The-Reto/DIY-Laserprojector_ASTEROIDS/README.md

# DIY-Laserprojector_ASTEROIDS
A clone of the popular arcadegame ASTEROIDS, emulated on a DIY Laserprojector

Please read the Report found in \Documentation for any further detail.
