The-Reto/DIY-Laserprojector_ASTEROIDS/Documentation/Report.pdf

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

# Introduction

## Summary

We are a team of three Computational Sciences students at the University of Basel. For this project we built a laserprojector using a module of 15 Kpps galvometric mirrors, a RGB-Lasermodule and an Arduino MEGA. We used this setup to emulate the classic arcade game ASTEROIDS, since the original release of this game made use of vectorized displays any pixel-based emulation is inherently inaccurate. Using our projector we were able to emulate ASTEROIDS using and directly displaying vector graphics.
The rst part of this document serves as a project report which has to be turned in for grading. The second part will go into further detail for anyone interested in how exactly we handled the technical aspects of the project. The project code as well as this document are available on GitHub (https://github.com/The-Reto/DIY-Laserprojector_ASTEROIDS).

## Context

This project was carried out within the scope of the accompanying lecture "Computer Architecture and Operating Systems" (CAOS) held by Professor Florina M. Ciorba and Professor Christian Tschudin at the University of Basel in the autumn semester of 2019.

## Team Members

The team for this project consisted of:

- Altava
- The_Reto
- L3ivel

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

# Chapter 1

# Idea & Inspiration

## 1.1 What Is a Laserprojector?

A laserprojector is a device that uses laser beams and a set of mirrors to deect those beams in order to draw lines over the projecting surface. It is used in industry for high precision tasks such as CNC machines, boat construction or leather nesting. It is also sometimes used for home entertainment as an alternative to beamers.

1.1.1 Principle

A laserprojector uses a single laser source or a combination of red, green and blue (RGB) aligned lasers. The single laser beam is then deected using two small mirrors attached to galvometric motors. It works a lot like a traditional beamer with the main dierence being that it only uses a single source of light.

1.1.2 Advantages

Laser projectors have a few advantages that make them a considerable alternative to traditional beamers. They are extremely accurate and have a wide optical angle, meaning that they can be placed very close to the projecting surface. Furthermore they consume less energy an are overall cheaper than traditional beamers.

## 1.2 Inspiration - Why Build One Yourself?

The idea to build a laserprojector came from a Youtube video from the creator "StandUpMaths". In his video titled "Recreating Asteroids with Lasers"¹ he describes the use of a laserprojector to emulate the classic arcade game ASTEROIDS. The original release of ASTEROIDS used a vector based display for all of its elements and can thus not be emulated to 100% accuracy on pixel-based monitors. The video also describes the principle of laserprojectors.
We also found several similar projects online²,3, we used these as further inspiration and reference. Generally speaking we did not use their code directly, the only two exceptions are detailed in the Technical Documentation (see 4.4 and 5.2.3).
Our team decided that the challenge of building a laserprojector would be a good t for the lecture. The problem we aimed to solve is evident, we wanted to accurately emulate ASTEROIDS and our main question is "can we do so within our budget and using a laser and a galvometric mirror?".

1https://youtu.be/FkHjG759ABY2https://www.instructables.com/id/Arduino-Laser-Show-with-Full-XY-Control3https://www.instructables.com/id/Arduino-Laser-Show-With-Real-G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

# Chapter 2

# Project Management

In this chapter we will outline our planning for the project as well as the actual execution and details where and why we deviated from our original plan.

## 2.1 Goals

We divided our goals into three categories with varying priority. The rst category is "Must Have" and is used for the goals we regard as the absolute minimum for our project to be considered a success. The second category, "Nice to Have", are goals ond features we'd very much like to accomplish but are not necessarily crucial for a bare bones version of the project. We labelled the last category as "Perfect Outcome", these are goals and featuers that are in no way necessary and may entail a massive amount of extra work - one could say these are the utopic goals.

Level | Goals
Must Have | Drawing Lissajous-Figures
Drawing arbitrary closed gures
Drawing arbitrary gures
Nice to Have | RGB-Laser for a visually more appealing results
Implementation of the ASTEROIDS game core Dimming the lasers using PWM for larger color-depth Perfect Outcome Speaker for generating sounds
Fully functioning ASTEROIDS emulation

## 2.2 Budget

Before starting the project we decided on a budget of CHF 300. We were in agreement that we'd pay all the hardware ourselves and not take advantage of the university's oering to carry parts of the costs as this would lead to the university owning parts of our hardware resulting in us having to disassemble the project once it would have been graded. By carrying all the costs ourselves we can avoid that.
After some discussing we decided that each of us would be willing to invest CHF 100, resulting in a total budget of CHF 300.

## 2.3 Distribution of tasks

Because we were condent that we'd reach all of our "Must Have" goals we were able to split the project into three parts and thus assign each team member one part. The three parts we identied were:

- Hardware
| All things related to hardware issues. What parts to use? How to mount them? Can the whole system be

portable?
Altava took responsibility for this part.
- IO-Software
Providing software abstractions for the laserpoint on the wall as well as the buttons and other parts. For use in various applications.
The_Reto took responsibility for this part.
- ASTEROIDS-Clone
The main application of our project. A functioning ASTEROIDS clone running on our hardware and using the abstractions provided by the basic IO-Software.
L3ivel took responsibility for this part.

Of course there are some overlapping areas between these three parts but they seemed distinct enough to warrant the division. While intensive communication was obviously still necessary, this nonetheless allowed each one of us to have his own schedule and workow. It also facilitates guring out each team member's contribution to the project.

## 2.4 Schedule

We did not plan out our schedule into too much detail in advance. Instead we decided to follow our goals according to their priority and seeing how far we'd get.

2.4.1 Hardware

As soon as the project idea was pitched to the teaching assistants and they gave the go-ahead, the vital hardware parts (mirrors, laser diodes, Arduino, etc.) were ordered.
The plan was to assemble the hardware once it has arrived and then start thinking about additional parts by the time the software caught up. For example we rst ordered cheap red laser diodes and planned to upgrade as soon as we were condent that the system would work.

2.4.2 Software

Since the software development was split in two parts (see 2.3), two separate plans were required. One for the IO-Software and one for the ASTEROIDS-clone.

IO-Software

The plan for the IO-Software was to start at the lowest level close to the hardware (outputting analog signals to the mirrors) and then add levels of abstractions as time goes on (letting the user set the position of the laserpoint instead of analog levels on the DAC, etc).

ASTEROIDS

The idea was to develop a platform independent ASTEROIDS-clone that could then, once the hardware and the IO-Software was done, be displayed using our projects hardware and codebase.

2.4.3 Documentation

The plan for the documentation was to wait until at least the "Must Have" goals were reached and then start to write the documentation and project report as a team eort.

## 2.5 Timeline

The following list shows a selection of major milestones in the project. Some of the dates are approximate.

Date | Milestone
07.11.2019 | Project presentation in lecture.
08.11.2019 | First time the whole system is assembled and run.
| Circles and Lissajous-gures are drawn.
09.11.2019 | Hardware is assembled into the box.
11.11.2019 | Buttons arrive and are mounted onto the box.
14.11.2019 | First successful drawing of a non-Lissajous-gure.
| We are able to draw the house gure that is still in the code.
16.11.2019 | Wiring for the buttons is done and the fan is mounted.
23.11.2019 | The box is painted, and the 3D-printed fan covers are mounted.
29.11.2019 | RGB-laser module arrives. First test of the colored laser.
| It is not yet mounted into the box.
30.11.2019 | TextRenderer is working. First display of text.
10.12.2019 | Sound module is working. We're annoying everyone in our vicinity
| with the piezo buzzer.
19.12.2019 | The RGB-Laser module is mounted into the box.
11.01.2020 | The Asteroids clone is run for the rst time.


(a) First assembly of the core parts. Note the imperfec-


tions at the edges of the square | (b) Drawing Lissajous gures.


(c) The nished laser projector. | (d) The Christmas tree gure.

# Chapter 3

# Result & Outlook

Our main goal was to create a fully functioning ASTEROIDS clone. We did not completely reach this goal. While playable, our clone is far from being complete. All in all we are still happy with our result. Details on the hardware and the software can be found in part II of this document.
However, there is a lot more we can do with the hardware and libraries we created. With our sound library and the saved RTTTL songs, we could set up a jukebox with a menu where you can select melodies to play (see 5.2.3). Another option is to nish the SVG-converter (see 5.3.2). This would allow for the user input of any .svg le that could then be displayed by our projector.
Finally we could combine all of these features in a selection menu and turn our box into a multimedia station.

## 3.1 Challenges & Deviations From Original Idea

Drawing Lissajous gures worked quite early, so we were condent that drawing closed gures would be easily achievable. Our rst idea was to use a two dimensional Fourier transform to display arbitrary closed gures, but it turned out that our xedpoint arithmetics library lacked the neccessary precision to deliver satisfactory results. We thus decided that we'd forego the Fourier transform and instead just move the laser point from vertex to vertex in a straight line. Yet it turned out to be a major obstacle to even draw clean straight lines. It appeares that the mirrors "overshoot" the target position, so when we tell them to move from position (x0,y0) to position (x0,y1), the laserpoint would stop at (x0,y1+a) and then move back, leveling out at the desired position. We suspect that this eect is due to the angular momentum of the mirrors. Our current solution is to add points inbetween, so that the mirrors don't accelerate too much and therefore reduce overshooting.
Another challenge was the arrangement of the parts in the box. We started assembling the parts into the box pretty early and a lot of the setup changed afterwards. When we installed the cooling system, which is very space consuming, we had to cut out vents and nd a suiting place for the fan. All of this had to be done without knowing the dimensions of the RGB laser module, as it arrived very late and had no technical specications provided by the seller. The interior of the box underwent several iterations, but ended up in a pretty good state, despite all the unknown variables.
After testing we found that our idea of using PWM to allow dimming of the lasers turned out to be impossible. While applying a modulated output to a stationary laser point creates the illusion of dimming the point, this technique stops working as soon as the laser point is in motion. It turns out the dimming eect on the laser point arrises from the point being turned on and o in rapid succession. When we move the laser point around using the mirrors this results in dashed or dotted lines - while this is a cool eect, it is not what we were aiming for.
The idea of adding sound came very late, but ended up being a good decision as it didn't really intervene with the rest of the project and adds very nice to the arcade feeling of our ASTEROIDS clone.
The installation of an RGB laser was decided on in the early stages of the project. We agreed that it would enhance the quality without adding much complexity. It turned out to do just that.

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

# Chapter 4

# Hardware

## 4.1 Parts Overview


Figure 4.1: The interior of our laser projector. On the left side is the lid where the buttons and the fan are embedded. On the right side are all the other parts mounted in the box.

All the parts of our laser projector are mounted in a 24cm x 17cm x 12cm wooden box. The buttons are embedded in the lid as well as the heat exhaust. On the back side is a sealable opening where the laser beam will come out of. The whole projector is powered by a single standard Swiss type power plug.

## 4.2 Arduino

The Arduino MEGA2560 controlling our projector is mounted on the bottom of the box and barely visible under the wires. It is connected to the DAC, the laser, the piezo buzzer and the buttons as well as their lights.

4.2.1 Pin Connections

Most of the Arduino output is connected to a standard breadboard using jumper wires. The DAC and the piezo buzzer are located on the breadboard, as well as some amplier circuits.
The pins of the Arduino are connected as follows.
Part | Pin Number
Piezo Buzzer | 47
SDI (DAC) | 51
SCK (DAC) | 52
CSP (DAC) | 53
LDAC (DAC) | 5
Red Laser | 40
Green Laser | 41
Blue Laser | 42
Button Interrupts | 2, 18-21
Button Lights | 30-34
4.3 | Mirrors & Galvometric Motors

Two small mirrors mounted on galvometric motors are the heart of our projector. The mirrors are capable of 25kppm (kilo points per second), meaning they can draw 25'000 distinguishable points per second on the projection surface. The motors are controlled by an accompanying PCB (printed circuit board). It can be seen right of the mirrors, mounted on the wall. The PCB has two MOSFETs (MetalOxideSemiconductor Field-Eect Transistor) and a small heatsink attached. Those MOSFETs develop a reasonable amount of heat in just a few minutes of operation, surpassing the capabilities of the already installed heatsink. This lead us to attaching a much bigger heatsink to the existing one and the additional installment of a fan.

## 4.4 DAC

The DAC (Digital-to-Analog Converter) is needed as a translator between the Arduino and the galvometric motors. It converts the digital signals of the Arduino to analog signals needed by the galvometric motors. We use a MCP4922 DAC.

## 4.5 Laser

We use an RGB laser so we can project dierent colors instead of only one. In the early stages of our project we used a cheap red laser and were not satised with the results, so we decided to upgrade our projector. The accompanying PCB is connected to the Arduino and lets us turn the dierently colored lasers (red, green and blue) on and o separately.

## 4.6 Power Supply

The power cord is connected to two dierent power supply units. One has a 15V output and powers the galvometric motors and the fan. The other one has a 5V output and powers the laser as well as the Arduino.


Figure 4.2: The laser and its controller.

4.7 | Additional Parts
4.7.1 | Buttons


Figure 4.3: Some disassembled buttons.

For playing Asteroids you need ve buttons. We used the 60mm Red Arcade Buttons by Adafruit for a real arcade-like feeling.¹ The buttons are equipped with an LED and can be lit individually by the Arduino.

4.7.2 Cooling

As mentioned in section 4.3, the operation of the galvometric mirrors produces a signicant amount of heat. In order to cool the MOSFETs, we attached a large heat sink to the existing one. This alone is a vast improvement and allows for operation over several hours with reasonable temperature development. Still we decided to install a fan and two vents to dissipate the hot air in order to protect the parts and box from taking damage.

1This project is not sponsored or supported by Adafruit in any way.

4.7.3 Box

The box is handmade out of 2cm thick maplewood. It is painted with acryllic color in the style of the original Asteroids arcade cabinet.

4.7.4 Piezo Buzzer

A late addition to the project was a piezo buzzer for simple arcade sounds, further improving the emulation of an Asteroids arcade cabinet. It is controlled by the Arduino and can generate simple notes by turning the input signal on and o at certain frequencies.

4.7.5 Other Parts

Several parts are 3D-printed. This includes the laser protection cover, the louvres and the stand aligning laser and mirrors.

## 4.8 Cost Overview

The total cost for the project ended up as follows.

Part | Price (all prices in CHF)
laser diode red | 6.00
galvometric motors with mirrors | 125.90
RGB laser module | 48.90
power supply for laser | 28.90
Arduino MEGA | 20.00
DAC | 16.00
Arcade Buttons | 29.10
Heat Sink | 5.55
Other (Resistors, Wires, Shipping etc.) | 62.40
Total | 342.75

# Chapter 5

# Software

5.1 | Software Overview & Structure
5.2 | IO Software
5.2.1 | Graphics

We provide an abstraction for the laser and the mirrors. Instead of worrying about the mirrors and the laser directly, the user should only worry about the laserpoint on the wall. The most important function in that regard is probably the following which controls the laserpoint on the wall.

1 moveLaser ( Laser *l , Command c)
A further abstraction is provided with the Drawing and Scene structs used to hold even higher level abstraction for pictures to be drawn. In the following paragraphs the details of each level of abstraction are provided.

DAC

As outlined in the hardware section (4) of this documentation, the mirrors are not directly connected to the Arduino. Instead the mirrors are connected to a DAC, the analog output is then used to control the angle of the mirrors. To control the DAC we copied, adapted and build upon public domain code found on GitHub¹
The DAC.cpp le provides functions controlling the DAC and setting its output level. This le denes a struct DAC containing the appropriate pin connections. The le provides the function DAC *generateDAC(int _SDI, int _SCK , int _CS, int _LDAC) that can be used to initialize a DAC-struct to then be used. The function also initializes the SPI-library, which is used to transfer the data to the DAC.
The function void Set(DAC *dac, unsigned int A, unsigned int B) is used to set the DAC provided in the argument *dac to the levels provided in the two arguments A and B, using the rst output channel of the DAC for the value in A and the second one for the value on the B argument. The two arguments must be between 0 and 4095, as we are using a 12-bit DAC.
The library denes the following datastructures:
- struct MCP4922 {int _SDI, _SCK, _CS, _LDAC}
holds the pin connections for the MCP4922 DAC we're using.
- typedef struct MCP4922 DAC
provides an easier name for the struct used to hold the pin connections.

The library provides the following functions:

- DAC* generateDAC(int _SDI, int _SCK, int _CS, int _LDAC)
returns a pointer to a DAC object using the provided pin numbers.
- void Set(DAC* dac, unsigned int A, unsigned int B)
sets the output channel A of the DAC provided in dac to the value in the argument A. sets the output channel B of the DAC provided in dac to the value in the argument B.

1https://github.com/helgenodland/MCP4922-Arduino-SPI-Library

Laser

The les Laser.cpp and Laser.h are probably the most important pieces of code in the whole project, as they provide the necessary functions to fully control the laser point on the wall. They provide functions, datastructures and constants for controlling position, movement and color of the laser.
The goal is to provide a level of abstraction to allow the user to control the laser point on the wall, instead of having to worry about the angle of the mirrors or the laser module.
The library provides the following datastructures:
- typedef unsigned char COLOR
Just a typedef for unsigned char to indicate its use as a color.
An unsigned char holds 8 bits, the rst two are unused for COLOR, the remaining 6 bits are shared equally across the three color-channels RGB, with two bits each. The structure is thus: EE RR GG BB
Example: 51 = 00 11 00 11 is equivalent to the color purple ({255, 0, 255}).
Note: On the current hardware we have no possibility of dimming the laser, nor the individual color-channels. This means that, currently, the laser corresponding to one color-channel will be fully activated whenever either one or both of the corresponding bits is set - eectively reducing our color-depth from 6 bits to 3.
- typedef unsigned long COMMAND
A typedef masking an unsigned long as a COMMAND. These commands are used to encode a new position for the laser to move to as well as a color during the move - thus allowing to encode any movement of the laser into 32 bits. This has two main advantages; rst it is ecient with memory, and secondly it allows the SVG-Converter (see 5.3.2) to output a CSV le containing numbers, which then in turn can easily be used on the hardware. The 32 bits of a unsigned long are used as follows:

The rst 12 bits encode the x-position.
the next 12 bits encode the y-position.
the following 6 bits encode the color (see COLOR)
the bit at the second to last position is the COLOR_CHANGE-bit. As changing the color of the laser takes a comparably large time (approx. 200 microseconds) the lasers color is not set for every point - rather it is only changed when the COLOR_CHANGE-bit is set.
the last bit is the LASER_OFF-bit, if it is set the laser will always be turned o (color black).

The overall structure of a COMMAND is thus: (x for the x-position, y for the y-position, rgb for the color and t for the two technical bits)

xxxx xxxx xxxx yyyy yyyy yyyy rrgg bbtt

- struct Laser
with the following structure:
1 | struct Laser {
2 | int x , y;
3 | COLOR color ;
4 | # ifdef USE_SIMULATOR
5 | int frame ;
6 | IMAGE target ;
7 | # else
8 | DAC dac ;
9 | # endif // USE_SIMULATOR
10 | };

This structure is used to describe one laser point (yes, we could theoretically use more than one). It holds the current position of the point and its current color. Depending on whether the simulator (see 5.3.2) is used or the actual hardware, the struct also holds either a DAC-object for use with the real hardware, or a frame for the simulator.

The library provides the following functions:

- LASER* generateLaser()
returns a laser struct with all the necessary variables initialized. The position is set to be at 2000, 2000 and the color is set to be black (i.e. laser turned o).
- void setLaserColor(LASER *l, COLOR col)
Sets the laser to the color provided.
Note: Our current hardware does not support dimmed color, see previous note on the color data structure.
- int deleteLaser(LASER* l)
Deletes the provided laser, freeing all allocated space.
- void moveLaser(LASER* l, COMMAND cmd)
Moves the laser point from its current position to the position encoded in the COMMAND. During the move the laser will keep its previous color, unless the COLOR_CHANGE-bit is set. In this case the laser will rst change its color to the color encoded in the COMMAND.
- COLOR getColor(COMMAND cmd)
Returns the color value encoded in the COMMAND cmd as a COLOR.
- COMMAND getCommand(unsigned short xPos, unsigned short yPos, COLOR col)
Returns a valid COMMAND encoding the position (xPos, yPos) and the COLOR col. Neither the COLOR_CHANGE nor the LASER_OFF-bit is set. If desired, they have to be set manually by adding the appropriate constant.
- COMMAND addCorrection(int x, int y, COMMAND c)
Adds an oset to the position in the provided COMMAND.

Drawing

The library Drawing provides further abstractions for the graphical output of our projector. Providing a struct called drawingObject holding position, rotation, scale etc. of a drawable object. Furthermore it allows for the grouping of several drawingObcects into a scene consisting of an array of drawingObjects and, crucially, an array of COMMANDs that can directly be drawn using the laser class.
The library provides the following datastructures:
- struct drawingObject
with the following structure:
1 | struct drawingObject {
2 | char type ;
3 | Vector pos ;
4 | short rot ;
5 | short scale ;
6 | int len ;
7 | COLOR color ;
8 | const short * data ;
9 | };
- struct scene
with the following structure:
1 | struct scene {
2 | int noOfObjects ;
3 | int noOfPoints ;
4 | drawingObject objects [16];
5 | COMMAND * cmds ;
6 | };

The library provides the following functions:

- scene* makeScene()
Returns a pointer to an empty scene object.
- void deleteScene(scene* s)
Deletes a scene, freeing all allocated memory. Scenes must be destroyed this way.

- void addObjectToScene(scene* scene, drawingObject object)
Adds a drawingObject to the scene provided.
- void buildScene(scene* s)
Renders the scene by iterating through all the objects in the scene and generating the array of commands. Note: This function must be called before the scene is drawn the rst time. It must also be called when there have been updates to the position, rotation or any other relevant eld of an object.
- void drawScene(scene toDraw, LASER l)
Draws the scene using the laser provided.

The library provides the following constants and variables:

- static drawingObject HOUSE
A drawingObject providing the image of a simplied house.
- static drawingObject SHIP
A drawingObject providing the image of a spaceship - this is the graphic used in the ASTEROIDS game.
- static drawingObject ROCK
A drawingObject providing the image of an abstract boulder - this is the graphic used for the eponymous asteroids in the game.
- static drawingObject TREE
A drawingObject providing the image of a simplied (Christmas) tree. This object was added shortly before Christmas to aid with the festive spirit during development.


Figure 5.1: Visualization of the forms we can draw.

TextRenderer

The TextRenderer library is used to render text onto a scene. The library provides the following function:

- void renderString(scene* s, String str, Vector pos, COLOR col)
Adds objects to the scene* s to spell out the string provided. Vector pos provides the position of the rst letter in the string and COLOR col the color of the whole string.

The library provides the following constants and variables:

- extern const drawingObject alphabet[]
An array of drawingObjects containing the upper case letters of the latin alphabet in alphabetical order. Numbers to be added soon.

5.2.2 Buttons

The CAOSButtons library provides all the functionality of the ve buttons on top of the box. It allows the user to set each button individually to one of three behaviours (trigger when button down, button up or button change). The library is also used to control the LED in each of the buttons for light eects.
The library supports the following ve buttons corresponding to our hardware:
- L_BUTTON (Left Button)
- T_BUTTON (Thrust Button)
- R_BUTTON (Right Button)
- F_BUTTON (Fire Button)
- H_BUTTON (Hyperspace Button)

The buttons can be in one of the following modes:

- BUTTON_DOWN
The action assigned to the button in question is triggered whenever the button goes from "not pressed" to "pressed".
- BUTTON_UP
The action assigned to the button in question is triggered whenever the button goes from "pressed" to not "pressed".
- BUTTON_CHANGE
The action assigned to the button in question is triggered whenever the button changes its state.

Each of the lights can be set to one of the following states:

- ON
The light will be turned on.
- OFF
The light will be turned o.
- RANDOM
The light will be randomly assigned to be on or o.
- SAME
The light will not change its state.
Note: This functionality comes in handy when one tries to change multiple (but not necessarily all of them) lights at once using the setLightPattern function (see below).

The library provides the following functions:

- void setUpButtons()
Sets up all the buttons, attaches the appropriate interrupts and sets the concerning hardware pins to the appropriate mode.
Note: This function must be called before any of the functionalities of the library can be used.
- void setInterrupt(char button, char mode, void (*f)())
This function is used to set the desired behaviour of a button. The user can specify the button in question, the mode desired and a function pointer to the function that should be called whenever the trigger criterion is met.
char button can be set to either one of the following: L_BUTTON, T_BUTTON, R_BUTTON, F_BUTTON, H_BUTTON.
char mode can be set to either one of the following: BUTTON_DOWN, BUTTON_UP, BUTTON_CHANGE.
void (*f)() can be set to an arbitrary function, that is to be triggered when the criterion set in mode is met.

- void setLight(char button, char state)
This function is used to set the state of an individual light. char button can be set to either one of the following:
L_BUTTON, T_BUTTON, R_BUTTON, F_BUTTON, H_BUTTON.
char state can be set to either one of the following:
ON, OFF, RANDOM, SAME.
- void setLightPattern(char *pattern)
Function used to set all the states of the lights at once.
char *pattern is an array containing ve states, the lights in the buttons will be set to the corresponding state (order is the one given above: [L, T, R, F ,H]).
- void setRandomLightPattern()
Sets all ve lights to RANDOM.

5.2.3 Sound

The sound library provides all functionality for the piezo buzzer used in the project. This functionality consists of the ability to play single notes for a given amount of time or to play one of the 20 handpicked songs available. These songs are stored in the RTTTL (Ring Tone Text Transfer Language, developed by Nokia in the 1990 to facilitate sharing and creating of monotone ringtones).
The code was largely copied and then adapted from a public GitHub project²
. The songs available in the RTTTL are copied from a le containing over 42'000 such songs we found online³,4
The library provides the following constants and variables:
- Frequencies of all 88 standard piano keys
These are provided as compile time makros of the format NOTE_ plus name. The names range from B0 to DS8. Example: The note C of the 4th octave has the following denition:
#define NOTE_C4 262.

- Strings containing 20 selected songs and melodies
Note: Not all of the melodies are equally recognisable when played on a piezo buzzer.

const char SIMPSONS[]
The intro melody of the hit TV-series The Simpsons.

const char INDIANA_JONES[]
The intro to the title piece of the movie Indiana Jones.

const char TAKE_ON_ME[]
The melody of the song Take On Me.

const char LOONEY_TUNES[]
The intro melody of the hit TV-series LOONEY TUNES.

const char TWENTYEST_CENT_FOX[]
The melody of the 20th Century Fox production logo.

const char JAMES_BOND[]
The musical motif associated with the movie hero James Bond.

const char STAR_WARS[]
The intro to the opening theme of Star Wars.

const char TOP_GUN[]
The intro to the opening theme of the movie Top Gun.

const char A_TEAM[]
The intro melody of the hit TV-series The A-TEAM.

const char FLINTSTONES[]
The intro melody of the hit TV-series The Flintstones.

2https://github.com/spicajames/Rtttl3http://www.picaxe.com/RTTTL-Ringtones-for-Tune-Command4http://www.cellringtones.com

const char SMURFS[]
The intro melody of the hit TV-series The Smurfs.

const char MISSION_IMPOSSIBLE[]
The intro of the opening theme of the Mission Impossible movies.

const char WORMS[]
The melody of the hit computer game Worms.

const char PIRATES[]
The intro to the opening theme of the The Pirates of the Carrabian movies.

const char SCHWEIZER_PSALM[]
The opening bars of the Swiss National Anthem.

const char FINAL_COUNTDOWN[]
The melody of the refrain of the song The Final Countdown.

const char BOHEMIAN[]
The opening bars of the song Bohemian Rhapsody.

const char FUR_ELISE[]
The opening bars of the song Für Elise.

const char MY_HEART_WILL[]
The melody of the refrain of the song My Heart Will Go On.

const char HARRY_POTTER[]
The intro to the opening theme of the Harry Potter movies.

The library provides the following functions:

- void playTone(int freq, long duration)
Used to play a single frequency int freq for a given amount of time long duration in milliseconds.
This function is non blocking - meaning the rest of the code can be executed while the tone is playing (e.g. there can be a graphics output at the same time).
- void play_rtttl(const char p[])
Plays the melody provided in const char p[]. One can either use one of the included RTTTL strings or input anotherone, the string (p[]) must however be stored in the program memory of the Arduino.
This function is blocking - meaning that no other action can be executed while the song is played. This unfortunatelly forbids us from playing a song while also displaying an image at the same time.
5.3 | Utilities
5.3.1 | Mathematical Tools

Fixed point arithmetics

The FixPoint library provides arithmetics for xed point numbers. We chose to use xed point arithmetics instead of standard oating point for performance reasons, as we decided that they also provide the neccesary precision. The library provides the following datastructures:

- typedef long FIXPOINT
A typedef used to indicate that a given variable of type long should be interpreted as an FIXPOINT.
- typedef unsigned long U_FIXPOINT
A typedef used to indicate that a given variable of type unsigned long should be interpreted as an U_FIXPOINT.

In either case (singed or unsigned) our xed points use 16 bits of precision.
The library provides the following functions:
- FIXPOINT intToFixed(int x)
Converts an integer into its xed point representation.

- int fixedToInt(FIXPOINT x)
Converts a xed point value into an integer. Non integer values are always rounded down.
- FIXPOINT doubleToFixed(double x)
Converts a oating point number into its xed point representation.
- double fixedToDouble(FIXPOINT x)
Converts a xed point value into its oating point counterpart.
- FIXPOINT fpMultiplication(FIXPOINT x, FIXPOINT y)
Multiplies two xpoint values together. Attention, this operation may lead to a loss in precision.
- FIXPOINT fpDivision(FIXPOINT x, FIXPOINT y)
Divides the xed point value x by y. Attention, this operation may lead to a loss in precision.
- FIXPOINT fpSin(int angle)
Returns the xed point representation of the sine of the provided angle.
int angle is to be given in degrees, but does not have to be between 0 and 360. The calculation of the sine is done using a lookup table and there is currently no interpolation for values with a precision greater than 1 degree implemented.
- FIXPOINT fpCos(int angle)
Returns the xedpoint representation of the cosine of the provided angle.
int angle is to be given in degrees, but does not have to be between 0 and 360. The calculation of the cosine is done using a lookup table and there is currently no interpolation for values with a precision greater than 1 degree implemented.
- FIXPOINT fpErf(char x)
Returns the result of the following calculation: 1 + erf(6.1645∗(

x
256 −0.5))
2
This calculation may seem extraordinarily specic, and it certainly is. The values returned are always in [0, 1]. This function is used to interpolate lines using the laser as to not overshoot the target position. Again, the calculation is not actually carried out on the Arduino, instead a look up table is used.

Vector

For various applications in the project two dimensional vectors are used. The vector library provides basic functionality for these applications.
The library provides the following datastructures:
- typedef struct vector Vector
A typedef masking the vector structure (see below) for ease of use.
- struct vector{FIXPOINT x,y;}
A struct used to store the vectors.

The library provides the following functions:

- Vector add(Vector v1, Vector v2)
Adds the two vectors and returns the result as a new vector.
- Vector multiply(Vector v, int scale)
Scales the vector by the specied amount and returns a new vector.
- Vector rotate(Vector v, int angle)
Rotates the vector in the plane by the specied amount (in degrees) and returns a new vector.
- int eq(Vector v1, Vector v2)
Tests the two vectors for equality.
Returns 1 if they are equal and 0 otherwise.

5.3.2 Additional Software

Simulator

A simple simulator was written to test graphics related code without needing to have the hardware actually present. This only worked in the beginning and as the code base got more complicated the eort of maintaining it became too great. This subproject was thus stopped. The code can be viewed on The_Retos GitHub-Page, this documentation will not go into further detail.

SVG-Converter

In the early states of the project a subproject was launched with the idea of creating a piece of software that could read an arbitrary .svg le and convert it into an array of COMMANDS that could be used on the hardware.
While the core of the software works in principle (it is able to convert svg paths to discrete positions on the x-y plane), the program is not yet able to do so for an arbitrary .svg le and some manual 'polishing' of the input is still required.
Some of the graphics used in the project were actually sketched in a graphics program and then converted using the SVG-Converter, but the subproject was cut for time reasons and remains unnished. The code can be viewed on The_Retos GitHub page.
5.4 | ASTEROIDS Game
5.4.1 | How to Play

Our Asteroids Game is based on the 1979 Atari hit game ASTEROIDS. The player controls a spaceship and has the goal to shoot all the asteroids. There are three types of asteroids: big, medium and small. When hit, big asteroids splitter into three medium sized asteroids, medium sized asteroids splitter into three small asteroids and small asteroids disappear. The player has three lifes. Upon crashing into an asteroid the player loses one life. If the player has no lifes left he automatically loses.

Controls

Like in the original game, the player can control his actions by pressing ve dierent buttons. Two buttons are used to rotate, one to accelerate the spaceship. One button shoots a laser from the head of the ship and one button resets the position of the ship to the center of the map.

5.4.2 Game Entities

Models

The Models library contains important structs, enums and functions in order for the AsteroidsMain library to properly function.

- struct gameObject with the following structure:
1 | struct gameObject {
2 | struct drawingObject graphics ;
3 | Vector velocity ;
4 | enum TYPE type ;
5 | enum ASTRTYPE astrtype ;
6 | struct gameObject * next ;
7 | struct gameObject * previous ;
8 | FIXPOINT mostsouth ;
9 | FIXPOINT mostnorth ;
10 | FIXPOINT mosteast ;
11 | FIXPOINT mostwest ;
12 | };

A gameObject contains a drawingObject for the representation of its border points, a velocity vector for the representation of the direction and magnitude of the moving object as well as the enums TYPE and ASTRTYPE for the identication of the type of Object. Additionally it contains orientation values (mostsouth, mosteast, mostnorth and mostwest). Those make up the bounding boxes for the collision detection. A gameObject is an element of a list, therefore each object has a pointer to the previous and the next Object.

- struct gameObject* generateClosedFigure(FIXPOINT posx, FIXPOINT posy, int color, Vector velocity, enum TYPE typ,

enum ASTRTYPE astr)
Returns a new gameObject whose lines are connected to a closed gure (no loose ends). Asteroids and the player model are created this way.
- void rotateObject(struct gameObject *obj, int angle)
Rotates the border points in graphics in given gameObject around its center at a certain angle.

5.4.3 Game Functions

The essential logical functions for running the game are found in the AsteroidsMain library, of which the accessible ones are:

- struct gameObject* asteroidsInit()
Adds a player model and three big asteroids with initial velocities.
Returns list of objects with the player model as its rst entry.
- struct gameObject* getUpdate(FIXPOINT deltaT)
Calculates the new position of all entities according to timestep deltaT and checks for collisions. Returns a list of objects with the player model as its rst entry.
- void shoot()
Shoots a laser shot from the head of the player model.
- void playerRotation(int angle)
Rotates the player model counterclockwise at given angle.
- void playerAcceleration(int acceleration)
Accelerates player model in direction of its head.

Generally all parameter values (except for color) should be entered in their respective Fixpoint representation.

5.4.4 Game Logic

After initialization, the game progresses by calling getUpdate(FIXPOINT deltaT) with respective time steps. This function does the following:

1. Move Objects

As a rst step, Objects are moved according to their velocities and the time that has passed since the last call.

2. Check for Objects out of Bounds

The game eld ranges from 0 to 4096 in x and y direction. If an object is outside of the boundary after being moved, it is positioned on the contrairy end of the axis that exceeds the range.

3. Check for Collision

In our game, collision only occurs between asteroids and laser shots or between asteroids and the player. In order to improve the game's performance we decided to check for collision by comparing bounding boxes. This guarantees certain performance benets in exchange for collision precision. With this method it is possible to hit asteroids at a certain angle, even if it does not look like the collision should be possible.

4. Slow the Player

In the original ASTEROIDS game from 1979 the player is slowed down with time when moving. We decided to adopt this, so the game becomes more intuitive.

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

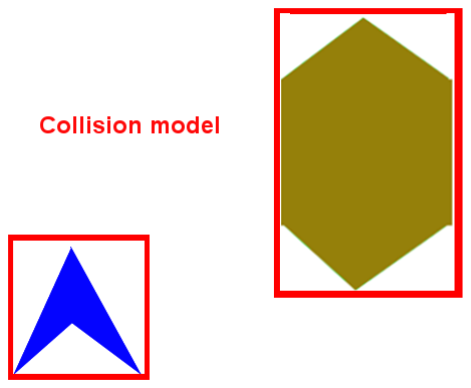
[picture p10: figure]
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
